HrishikeshGawasIIITH/4bit-cla-adder-180nm/post_layout_sim/full_chip/cla_final_layout.cir

.include TSMC_180nm.txt

.param LAMBDA=0.09u
.param W=20*LAMBDA
.param width_N=W
.param width_P=2*W
.global gnd vdd
.option scale=0.09u

Vdd vdd gnd 1.8

Vin_a0 a0_unsync gnd PULSE(1.8 0 0.375ns 50ps 50ps 0.8ns 1.6ns 0)
Vin_a1 a1_unsync gnd PULSE(1.8 0 0.375ns 50ps 50ps 1.6ns 3.2ns 0)
Vin_a2 a2_unsync gnd PULSE(1.8 0 0.375ns 50ps 50ps 3.2ns 6.4ns 0)
Vin_a3 a3_unsync gnd PULSE(1.8 0 0.375ns 50ps 50ps 6.4ns 12.8ns 0)

Vin_b0 b0_unsync gnd PULSE(1.8 0 0.375ns 50ps 50ps 12.8ns 25.6ns 0)
Vin_b1 b1_unsync gnd PULSE(1.8 0 0.375ns 50ps 50ps 25.6ns 51.2ns 0)
Vin_b2 b2_unsync gnd PULSE(1.8 0 0.375ns 50ps 50ps 51.2ns 102.4ns 0)
Vin_b3 b3_unsync gnd PULSE(1.8 0 0.375ns 50ps 50ps 102.4ns 204.8ns 0)
*change to 0.8ns
Vin_clk clk gnd PULSE(1.8 0 0 50ps 50ps 0.4ns 0.8ns 0)



M1000 c4 c4_0/a_72_9# vdd c4_0/inverter_0/w_0_n60# CMOSP w=40 l=2
+  ad=200 pd=90 as=21320 ps=9546
M1001 c4 c4_0/a_72_9# gnd Gnd CMOSN w=20 l=2
+  ad=100 pd=50 as=10900 ps=5410
M1002 c4_0/a_72_9# g3 c4_0/a_56_49# c4_0/w_3_39# CMOSP w=40 l=2
+  ad=200 pd=90 as=440 ps=182
M1003 c4_0/a_48_9# p2 c4_0/a_24_9# Gnd CMOSN w=20 l=2
+  ad=220 pd=102 as=220 ps=102
M1004 gnd g1 c4_0/a_24_9# Gnd CMOSN w=20 l=2
+  ad=0 pd=0 as=0 ps=0
M1005 c4_0/a_9_49# p1 vdd c4_0/w_3_39# CMOSP w=40 l=2
+  ad=440 pd=182 as=0 ps=0
M1006 gnd g2 c4_0/a_48_9# Gnd CMOSN w=20 l=2
+  ad=0 pd=0 as=0 ps=0
M1007 c4_0/a_32_49# p2 vdd c4_0/w_3_39# CMOSP w=40 l=2
+  ad=440 pd=182 as=0 ps=0
M1008 gnd g3 c4_0/a_72_9# Gnd CMOSN w=20 l=2
+  ad=0 pd=0 as=120 ps=52
M1009 c4_0/a_32_49# g1 c4_0/a_9_49# c4_0/w_3_39# CMOSP w=40 l=2
+  ad=0 pd=0 as=0 ps=0
M1010 c4_0/a_56_49# p3 vdd c4_0/w_3_39# CMOSP w=40 l=2
+  ad=0 pd=0 as=0 ps=0
M1011 c4_0/a_16_9# g0 gnd Gnd CMOSN w=20 l=2
+  ad=120 pd=52 as=0 ps=0
M1012 vdd g0 c4_0/a_9_49# c4_0/w_3_39# CMOSP w=40 l=2
+  ad=0 pd=0 as=0 ps=0
M1013 c4_0/a_56_49# g2 c4_0/a_32_49# c4_0/w_3_39# CMOSP w=40 l=2
+  ad=0 pd=0 as=0 ps=0
M1014 c4_0/a_72_9# p3 c4_0/a_48_9# Gnd CMOSN w=20 l=2
+  ad=0 pd=0 as=0 ps=0
M1015 c4_0/a_24_9# p1 c4_0/a_16_9# Gnd CMOSN w=20 l=2
+  ad=0 pd=0 as=0 ps=0
M1016 c2 c2_0/a_24_9# vdd c2_0/inverter_0/w_0_n60# CMOSP w=40 l=2
+  ad=200 pd=90 as=0 ps=0
M1017 c2 c2_0/a_24_9# gnd Gnd CMOSN w=20 l=2
+  ad=100 pd=50 as=0 ps=0
M1018 gnd g1 c2_0/a_24_9# Gnd CMOSN w=20 l=2
+  ad=0 pd=0 as=120 ps=52
M1019 c2_0/a_9_49# p1 vdd c2_0/w_3_39# CMOSP w=40 l=2
+  ad=440 pd=182 as=0 ps=0
M1020 c2_0/a_24_9# g1 c2_0/a_9_49# c2_0/w_3_39# CMOSP w=40 l=2
+  ad=200 pd=90 as=0 ps=0
M1021 c2_0/a_16_9# g0 gnd Gnd CMOSN w=20 l=2
+  ad=120 pd=52 as=0 ps=0
M1022 vdd g0 c2_0/a_9_49# c2_0/w_3_39# CMOSP w=40 l=2
+  ad=0 pd=0 as=0 ps=0
M1023 c2_0/a_24_9# p1 c2_0/a_16_9# Gnd CMOSN w=20 l=2
+  ad=0 pd=0 as=0 ps=0
M1024 a0 dff_0/a_64_49# vdd dff_0/inverter_0/w_0_n60# CMOSP w=40 l=2
+  ad=200 pd=90 as=0 ps=0
M1025 a0 dff_0/a_64_49# gnd Gnd CMOSN w=20 l=2
+  ad=100 pd=50 as=0 ps=0
M1026 gnd clk dff_0/a_40_9# Gnd CMOSN w=20 l=2
+  ad=0 pd=0 as=120 ps=52
M1027 dff_0/a_64_49# dff_0/a_33_9# vdd dff_0/w_3_39# CMOSP w=40 l=2
+  ad=200 pd=90 as=0 ps=0
M1028 dff_0/a_16_9# clk dff_0/a_16_49# dff_0/w_3_39# CMOSP w=40 l=2
+  ad=200 pd=90 as=240 ps=92
M1029 vdd clk dff_0/a_33_9# dff_0/w_3_39# CMOSP w=40 l=2
+  ad=0 pd=0 as=200 ps=90
M1030 dff_0/a_64_9# dff_0/a_33_9# gnd Gnd CMOSN w=20 l=2
+  ad=120 pd=52 as=0 ps=0
M1031 dff_0/a_16_9# a0_unsync gnd Gnd CMOSN w=20 l=2
+  ad=100 pd=50 as=0 ps=0
M1032 dff_0/a_16_49# a0_unsync vdd dff_0/w_3_39# CMOSP w=40 l=2
+  ad=0 pd=0 as=0 ps=0
M1033 dff_0/a_40_9# dff_0/a_16_9# dff_0/a_33_9# Gnd CMOSN w=20 l=2
+  ad=0 pd=0 as=100 ps=50
M1034 dff_0/a_64_49# clk dff_0/a_64_9# Gnd CMOSN w=20 l=2
+  ad=100 pd=50 as=0 ps=0
M1035 b0 dff_1/a_64_49# vdd dff_1/inverter_0/w_0_n60# CMOSP w=40 l=2
+  ad=200 pd=90 as=0 ps=0
M1036 b0 dff_1/a_64_49# gnd Gnd CMOSN w=20 l=2
+  ad=100 pd=50 as=0 ps=0
M1037 gnd clk dff_1/a_40_9# Gnd CMOSN w=20 l=2
+  ad=0 pd=0 as=120 ps=52
M1038 dff_1/a_64_49# dff_1/a_33_9# vdd dff_1/w_3_39# CMOSP w=40 l=2
+  ad=200 pd=90 as=0 ps=0
M1039 dff_1/a_16_9# clk dff_1/a_16_49# dff_1/w_3_39# CMOSP w=40 l=2
+  ad=200 pd=90 as=240 ps=92
M1040 vdd clk dff_1/a_33_9# dff_1/w_3_39# CMOSP w=40 l=2
+  ad=0 pd=0 as=200 ps=90
M1041 dff_1/a_64_9# dff_1/a_33_9# gnd Gnd CMOSN w=20 l=2
+  ad=120 pd=52 as=0 ps=0
M1042 dff_1/a_16_9# b0_unsync gnd Gnd CMOSN w=20 l=2
+  ad=100 pd=50 as=0 ps=0
M1043 dff_1/a_16_49# b0_unsync vdd dff_1/w_3_39# CMOSP w=40 l=2
+  ad=0 pd=0 as=0 ps=0
M1044 dff_1/a_40_9# dff_1/a_16_9# dff_1/a_33_9# Gnd CMOSN w=20 l=2
+  ad=0 pd=0 as=100 ps=50
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
+  ad=0 pd=0 as=200 ps=90
M1129 dff_9/a_64_9# dff_9/a_33_9# gnd Gnd CMOSN w=20 l=2
+  ad=120 pd=52 as=0 ps=0
M1130 dff_9/a_16_9# s1 gnd Gnd CMOSN w=20 l=2
+  ad=100 pd=50 as=0 ps=0
M1131 dff_9/a_16_49# s1 vdd dff_9/w_3_39# CMOSP w=40 l=2
+  ad=0 pd=0 as=0 ps=0
M1132 dff_9/a_40_9# dff_9/a_16_9# dff_9/a_33_9# Gnd CMOSN w=20 l=2
+  ad=0 pd=0 as=100 ps=50
M1133 dff_9/a_64_49# clk dff_9/a_64_9# Gnd CMOSN w=20 l=2
+  ad=100 pd=50 as=0 ps=0
M1134 xor_0/a_32_9# xor_0/a_16_9# gnd Gnd CMOSN w=20 l=2
+  ad=80 pd=48 as=0 ps=0
M1135 s0 b0 xor_0/a_54_9# Gnd CMOSN w=20 l=2
+  ad=200 pd=100 as=80 ps=48
M1136 vdd b0 xor_0/a_36_6# xor_0/w_3_39# CMOSP w=40 l=2
+  ad=0 pd=0 as=200 ps=90
M1137 xor_0/a_54_9# a0 gnd Gnd CMOSN w=20 l=2
+  ad=0 pd=0 as=0 ps=0
M1138 xor_0/a_54_49# a0 vdd xor_0/w_3_39# CMOSP w=40 l=2
+  ad=160 pd=88 as=0 ps=0
M1139 s0 xor_0/a_36_6# xor_0/a_54_49# xor_0/w_3_39# CMOSP w=40 l=2
+  ad=400 pd=180 as=0 ps=0
M1140 xor_0/a_32_49# xor_0/a_16_9# vdd xor_0/w_3_39# CMOSP w=40 l=2
+  ad=160 pd=88 as=0 ps=0
M1141 xor_0/a_16_9# a0 gnd Gnd CMOSN w=20 l=2
+  ad=100 pd=50 as=0 ps=0
M1142 gnd b0 xor_0/a_36_6# Gnd CMOSN w=20 l=2
+  ad=0 pd=0 as=100 ps=50
M1143 s0 b0 xor_0/a_32_49# xor_0/w_3_39# CMOSP w=40 l=2
+  ad=0 pd=0 as=0 ps=0
M1144 xor_0/a_16_9# a0 vdd xor_0/w_3_39# CMOSP w=40 l=2
+  ad=200 pd=90 as=0 ps=0
M1145 s0 xor_0/a_36_6# xor_0/a_32_9# Gnd CMOSN w=20 l=2
+  ad=0 pd=0 as=0 ps=0
M1146 c3 c3_0/a_48_9# vdd c3_0/inverter_0/w_0_n60# CMOSP w=40 l=2
+  ad=200 pd=90 as=0 ps=0
M1147 c3 c3_0/a_48_9# gnd Gnd CMOSN w=20 l=2
+  ad=100 pd=50 as=0 ps=0
M1148 c3_0/a_48_9# p2 c3_0/a_24_9# Gnd CMOSN w=20 l=2
+  ad=120 pd=52 as=220 ps=102
M1149 gnd g1 c3_0/a_24_9# Gnd CMOSN w=20 l=2
+  ad=0 pd=0 as=0 ps=0
M1150 c3_0/a_9_49# p1 vdd c3_0/w_3_39# CMOSP w=40 l=2
+  ad=440 pd=182 as=0 ps=0
M1151 gnd g2 c3_0/a_48_9# Gnd CMOSN w=20 l=2
+  ad=0 pd=0 as=0 ps=0
M1152 c3_0/a_32_49# p2 vdd c3_0/w_3_39# CMOSP w=40 l=2
+  ad=440 pd=182 as=0 ps=0
M1153 c3_0/a_32_49# g1 c3_0/a_9_49# c3_0/w_3_39# CMOSP w=40 l=2
+  ad=0 pd=0 as=0 ps=0
M1154 c3_0/a_16_9# g0 gnd Gnd CMOSN w=20 l=2
+  ad=120 pd=52 as=0 ps=0
M1155 vdd g0 c3_0/a_9_49# c3_0/w_3_39# CMOSP w=40 l=2
+  ad=0 pd=0 as=0 ps=0
M1156 c3_0/a_48_9# g2 c3_0/a_32_49# c3_0/w_3_39# CMOSP w=40 l=2
+  ad=200 pd=90 as=0 ps=0
M1157 c3_0/a_24_9# p1 c3_0/a_16_9# Gnd CMOSN w=20 l=2
+  ad=0 pd=0 as=0 ps=0
M1158 xor_1/a_32_9# xor_1/a_16_9# gnd Gnd CMOSN w=20 l=2
+  ad=80 pd=48 as=0 ps=0
M1159 p1 b1 xor_1/a_54_9# Gnd CMOSN w=20 l=2
+  ad=200 pd=100 as=80 ps=48
M1160 vdd b1 xor_1/a_36_6# xor_1/w_3_39# CMOSP w=40 l=2
+  ad=0 pd=0 as=200 ps=90
M1161 xor_1/a_54_9# a1 gnd Gnd CMOSN w=20 l=2
+  ad=0 pd=0 as=0 ps=0
M1162 xor_1/a_54_49# a1 vdd xor_1/w_3_39# CMOSP w=40 l=2
+  ad=160 pd=88 as=0 ps=0
M1163 p1 xor_1/a_36_6# xor_1/a_54_49# xor_1/w_3_39# CMOSP w=40 l=2
+  ad=400 pd=180 as=0 ps=0
M1164 xor_1/a_32_49# xor_1/a_16_9# vdd xor_1/w_3_39# CMOSP w=40 l=2
+  ad=160 pd=88 as=0 ps=0
M1165 xor_1/a_16_9# a1 gnd Gnd CMOSN w=20 l=2
+  ad=100 pd=50 as=0 ps=0
M1166 gnd b1 xor_1/a_36_6# Gnd CMOSN w=20 l=2
+  ad=0 pd=0 as=100 ps=50
M1167 p1 b1 xor_1/a_32_49# xor_1/w_3_39# CMOSP w=40 l=2
+  ad=0 pd=0 as=0 ps=0
M1168 xor_1/a_16_9# a1 vdd xor_1/w_3_39# CMOSP w=40 l=2
+  ad=200 pd=90 as=0 ps=0
M1169 p1 xor_1/a_36_6# xor_1/a_32_9# Gnd CMOSN w=20 l=2
+  ad=0 pd=0 as=0 ps=0
M1170 xor_2/a_32_9# xor_2/a_16_9# gnd Gnd CMOSN w=20 l=2
+  ad=80 pd=48 as=0 ps=0
M1171 p2 b2 xor_2/a_54_9# Gnd CMOSN w=20 l=2
+  ad=200 pd=100 as=80 ps=48
M1172 vdd b2 xor_2/a_36_6# xor_2/w_3_39# CMOSP w=40 l=2
+  ad=0 pd=0 as=200 ps=90
M1173 xor_2/a_54_9# a2 gnd Gnd CMOSN w=20 l=2
+  ad=0 pd=0 as=0 ps=0
M1174 xor_2/a_54_49# a2 vdd xor_2/w_3_39# CMOSP w=40 l=2
+  ad=160 pd=88 as=0 ps=0
M1175 p2 xor_2/a_36_6# xor_2/a_54_49# xor_2/w_3_39# CMOSP w=40 l=2
+  ad=400 pd=180 as=0 ps=0
M1176 xor_2/a_32_49# xor_2/a_16_9# vdd xor_2/w_3_39# CMOSP w=40 l=2
+  ad=160 pd=88 as=0 ps=0
M1177 xor_2/a_16_9# a2 gnd Gnd CMOSN w=20 l=2
+  ad=100 pd=50 as=0 ps=0
M1178 gnd b2 xor_2/a_36_6# Gnd CMOSN w=20 l=2
+  ad=0 pd=0 as=100 ps=50
M1179 p2 b2 xor_2/a_32_49# xor_2/w_3_39# CMOSP w=40 l=2
+  ad=0 pd=0 as=0 ps=0
M1180 xor_2/a_16_9# a2 vdd xor_2/w_3_39# CMOSP w=40 l=2
+  ad=200 pd=90 as=0 ps=0
M1181 p2 xor_2/a_36_6# xor_2/a_32_9# Gnd CMOSN w=20 l=2
+  ad=0 pd=0 as=0 ps=0
M1182 xor_3/a_32_9# xor_3/a_16_9# gnd Gnd CMOSN w=20 l=2
+  ad=80 pd=48 as=0 ps=0
M1183 p3 b3 xor_3/a_54_9# Gnd CMOSN w=20 l=2
+  ad=200 pd=100 as=80 ps=48
M1184 vdd b3 xor_3/a_36_6# xor_3/w_3_39# CMOSP w=40 l=2
+  ad=0 pd=0 as=200 ps=90
M1185 xor_3/a_54_9# a3 gnd Gnd CMOSN w=20 l=2
+  ad=0 pd=0 as=0 ps=0
M1186 xor_3/a_54_49# a3 vdd xor_3/w_3_39# CMOSP w=40 l=2
+  ad=160 pd=88 as=0 ps=0
M1187 p3 xor_3/a_36_6# xor_3/a_54_49# xor_3/w_3_39# CMOSP w=40 l=2
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
+  ad=100 pd=50 as=0 ps=0
M1240 s2_sync dff_10/a_64_49# vdd dff_10/inverter_0/w_0_n60# CMOSP w=40 l=2
+  ad=200 pd=90 as=0 ps=0
M1241 s2_sync dff_10/a_64_49# gnd Gnd CMOSN w=20 l=2
+  ad=100 pd=50 as=0 ps=0
M1242 gnd clk dff_10/a_40_9# Gnd CMOSN w=20 l=2
+  ad=0 pd=0 as=120 ps=52
M1243 dff_10/a_64_49# dff_10/a_33_9# vdd dff_10/w_3_39# CMOSP w=40 l=2
+  ad=200 pd=90 as=0 ps=0
M1244 dff_10/a_16_9# clk dff_10/a_16_49# dff_10/w_3_39# CMOSP w=40 l=2
+  ad=200 pd=90 as=240 ps=92
M1245 vdd clk dff_10/a_33_9# dff_10/w_3_39# CMOSP w=40 l=2
+  ad=0 pd=0 as=200 ps=90
M1246 dff_10/a_64_9# dff_10/a_33_9# gnd Gnd CMOSN w=20 l=2
+  ad=120 pd=52 as=0 ps=0
M1247 dff_10/a_16_9# s2 gnd Gnd CMOSN w=20 l=2
+  ad=100 pd=50 as=0 ps=0
M1248 dff_10/a_16_49# s2 vdd dff_10/w_3_39# CMOSP w=40 l=2
+  ad=0 pd=0 as=0 ps=0
M1249 dff_10/a_40_9# dff_10/a_16_9# dff_10/a_33_9# Gnd CMOSN w=20 l=2
+  ad=0 pd=0 as=100 ps=50
M1250 dff_10/a_64_49# clk dff_10/a_64_9# Gnd CMOSN w=20 l=2
+  ad=100 pd=50 as=0 ps=0
M1251 c4_sync dff_12/a_64_49# vdd dff_12/inverter_0/w_0_n60# CMOSP w=40 l=2
+  ad=200 pd=90 as=0 ps=0
M1252 c4_sync dff_12/a_64_49# gnd Gnd CMOSN w=20 l=2
+  ad=100 pd=50 as=0 ps=0
M1253 gnd clk dff_12/a_40_9# Gnd CMOSN w=20 l=2
+  ad=0 pd=0 as=120 ps=52
M1254 dff_12/a_64_49# dff_12/a_33_9# vdd dff_12/w_3_39# CMOSP w=40 l=2
+  ad=200 pd=90 as=0 ps=0
M1255 dff_12/a_16_9# clk dff_12/a_16_49# dff_12/w_3_39# CMOSP w=40 l=2
+  ad=200 pd=90 as=240 ps=92
M1256 vdd clk dff_12/a_33_9# dff_12/w_3_39# CMOSP w=40 l=2
+  ad=0 pd=0 as=200 ps=90
M1257 dff_12/a_64_9# dff_12/a_33_9# gnd Gnd CMOSN w=20 l=2
+  ad=120 pd=52 as=0 ps=0
M1258 dff_12/a_16_9# c4 gnd Gnd CMOSN w=20 l=2
+  ad=100 pd=50 as=0 ps=0
M1259 dff_12/a_16_49# c4 vdd dff_12/w_3_39# CMOSP w=40 l=2
+  ad=0 pd=0 as=0 ps=0
M1260 dff_12/a_40_9# dff_12/a_16_9# dff_12/a_33_9# Gnd CMOSN w=20 l=2
+  ad=0 pd=0 as=100 ps=50
M1261 dff_12/a_64_49# clk dff_12/a_64_9# Gnd CMOSN w=20 l=2
+  ad=100 pd=50 as=0 ps=0
M1262 s3_sync dff_11/a_64_49# vdd dff_11/inverter_0/w_0_n60# CMOSP w=40 l=2
+  ad=200 pd=90 as=0 ps=0
M1263 s3_sync dff_11/a_64_49# gnd Gnd CMOSN w=20 l=2
+  ad=100 pd=50 as=0 ps=0
M1264 gnd clk dff_11/a_40_9# Gnd CMOSN w=20 l=2
+  ad=0 pd=0 as=120 ps=52
M1265 dff_11/a_64_49# dff_11/a_33_9# vdd dff_11/w_3_39# CMOSP w=40 l=2
+  ad=200 pd=90 as=0 ps=0
M1266 dff_11/a_16_9# clk dff_11/a_16_49# dff_11/w_3_39# CMOSP w=40 l=2
+  ad=200 pd=90 as=240 ps=92
M1267 vdd clk dff_11/a_33_9# dff_11/w_3_39# CMOSP w=40 l=2
+  ad=0 pd=0 as=200 ps=90
M1268 dff_11/a_64_9# dff_11/a_33_9# gnd Gnd CMOSN w=20 l=2
+  ad=120 pd=52 as=0 ps=0
M1269 dff_11/a_16_9# s3 gnd Gnd CMOSN w=20 l=2
+  ad=100 pd=50 as=0 ps=0
M1270 dff_11/a_16_49# s3 vdd dff_11/w_3_39# CMOSP w=40 l=2
+  ad=0 pd=0 as=0 ps=0
M1271 dff_11/a_40_9# dff_11/a_16_9# dff_11/a_33_9# Gnd CMOSN w=20 l=2
+  ad=0 pd=0 as=100 ps=50
M1272 dff_11/a_64_49# clk dff_11/a_64_9# Gnd CMOSN w=20 l=2
+  ad=100 pd=50 as=0 ps=0
M1273 g0 and_0/a_7_63# vdd and_0/inverter_0/w_0_n60# CMOSP w=40 l=2
+  ad=200 pd=90 as=0 ps=0
M1274 g0 and_0/a_7_63# gnd Gnd CMOSN w=20 l=2
+  ad=100 pd=50 as=0 ps=0
M1275 and_0/a_7_63# b0 and_0/a_7_3# Gnd CMOSN w=40 l=2
+  ad=200 pd=90 as=240 ps=92
M1276 and_0/a_7_3# a0 gnd Gnd CMOSN w=40 l=2
+  ad=0 pd=0 as=0 ps=0
M1277 and_0/a_7_63# a0 vdd and_0/w_n6_53# CMOSP w=40 l=2
+  ad=240 pd=92 as=0 ps=0
M1278 vdd b0 and_0/a_7_63# and_0/w_n6_53# CMOSP w=40 l=2
+  ad=0 pd=0 as=0 ps=0
M1279 g1 and_1/a_7_63# vdd and_1/inverter_0/w_0_n60# CMOSP w=40 l=2
+  ad=200 pd=90 as=0 ps=0
M1280 g1 and_1/a_7_63# gnd Gnd CMOSN w=20 l=2
+  ad=100 pd=50 as=0 ps=0
M1281 and_1/a_7_63# b1 and_1/a_7_3# Gnd CMOSN w=40 l=2
+  ad=200 pd=90 as=240 ps=92
M1282 and_1/a_7_3# a1 gnd Gnd CMOSN w=40 l=2
+  ad=0 pd=0 as=0 ps=0
M1283 and_1/a_7_63# a1 vdd and_1/w_n6_53# CMOSP w=40 l=2
+  ad=240 pd=92 as=0 ps=0
M1284 vdd b1 and_1/a_7_63# and_1/w_n6_53# CMOSP w=40 l=2
+  ad=0 pd=0 as=0 ps=0
M1285 g2 and_2/a_7_63# vdd and_2/inverter_0/w_0_n60# CMOSP w=40 l=2
+  ad=200 pd=90 as=0 ps=0
M1286 g2 and_2/a_7_63# gnd Gnd CMOSN w=20 l=2
+  ad=100 pd=50 as=0 ps=0
M1287 and_2/a_7_63# b2 and_2/a_7_3# Gnd CMOSN w=40 l=2
+  ad=200 pd=90 as=240 ps=92
M1288 and_2/a_7_3# a2 gnd Gnd CMOSN w=40 l=2
+  ad=0 pd=0 as=0 ps=0
M1289 and_2/a_7_63# a2 vdd and_2/w_n6_53# CMOSP w=40 l=2
+  ad=240 pd=92 as=0 ps=0
M1290 vdd b2 and_2/a_7_63# and_2/w_n6_53# CMOSP w=40 l=2
+  ad=0 pd=0 as=0 ps=0
M1291 g3 and_3/a_7_63# vdd and_3/inverter_0/w_0_n60# CMOSP w=40 l=2
+  ad=200 pd=90 as=0 ps=0
M1292 g3 and_3/a_7_63# gnd Gnd CMOSN w=20 l=2
+  ad=100 pd=50 as=0 ps=0
M1293 and_3/a_7_63# b3 and_3/a_7_3# Gnd CMOSN w=40 l=2
+  ad=200 pd=90 as=240 ps=92
M1294 and_3/a_7_3# a3 gnd Gnd CMOSN w=40 l=2
+  ad=0 pd=0 as=0 ps=0
M1295 and_3/a_7_63# a3 vdd and_3/w_n6_53# CMOSP w=40 l=2
+  ad=240 pd=92 as=0 ps=0
M1296 vdd b3 and_3/a_7_63# and_3/w_n6_53# CMOSP w=40 l=2
+  ad=0 pd=0 as=0 ps=0
C0 p1 xor_1/a_36_6# 1.37fF
C1 s3 p3 0.42fF
C2 dff_3/a_16_9# dff_3/a_33_9# 0.17fF
C3 dff_0/a_16_9# gnd 0.24fF
C4 vdd inv_1/w_0_n60# 0.14fF
C5 xor_3/a_16_9# a3 0.07fF
C6 vdd a2 1.59fF
C7 gnd b1 0.90fF
C8 vdd dff_6/a_33_9# 0.45fF
C9 vdd dff_5/a_64_49# 0.45fF
C10 and_1/inverter_0/w_0_n60# vdd 0.14fF
C11 dff_3/a_33_9# vdd 0.45fF
C12 vdd dff_2/w_3_39# 0.39fF
C13 dff_7/w_3_39# b3_unsync 0.12fF
C14 c2_0/a_24_9# gnd 0.32fF
C15 dff_2/w_3_39# dff_2/a_16_9# 0.14fF
C16 s0 xor_0/a_16_9# 0.03fF
C17 b3 xor_3/w_3_39# 0.34fF
C18 dff_6/a_16_9# dff_6/a_33_9# 0.17fF
C19 vdd dff_4/w_3_39# 0.39fF
C20 c4_0/w_3_39# p2 0.23fF
C21 c4_0/inverter_0/w_0_n60# c4_0/a_72_9# 0.09fF
C22 xor_6/a_36_6# gnd 0.24fF
C23 vdd inv_3/w_0_n60# 0.14fF
C24 xor_1/w_3_39# b1 0.38fF
C25 gnd xor_1/a_16_9# 0.50fF
C26 c2_0/w_3_39# vdd 0.13fF
C27 vdd c4_0/a_9_49# 0.95fF
C28 s3 dff_11/w_3_39# 0.12fF
C29 and_3/w_n6_53# and_3/a_7_63# 0.04fF
C30 dff_6/inverter_0/w_0_n60# a3 0.08fF
C31 vdd and_2/a_7_63# 0.86fF
C32 dff_1/a_16_9# gnd 0.24fF
C33 and_2/a_7_3# gnd 0.47fF
C34 vdd dff_3/a_64_49# 0.45fF
C35 clk dff_8/a_16_9# 0.05fF
C36 gnd b2 0.79fF
C37 c2 xor_4/w_3_39# 0.18fF
C38 dff_7/w_3_39# vdd 0.39fF
C39 dff_11/a_16_9# gnd 0.24fF
C40 dff_9/a_64_49# dff_9/w_3_39# 0.08fF
C41 dff_9/a_33_9# dff_9/a_16_9# 0.17fF
C42 and_0/a_7_63# g0 0.05fF
C43 g0 gnd 1.93fF
C44 dff_0/inverter_0/w_0_n60# dff_0/a_64_49# 0.09fF
C45 b0_unsync dff_1/w_3_39# 0.12fF
C46 xor_1/w_3_39# xor_1/a_16_9# 0.16fF
C47 inv_2/w_0_n60# s2_sync 0.09fF
C48 s1 s0 0.11fF
C49 vdd dff_10/a_64_49# 0.45fF
C50 c3_0/a_16_9# c3_0/a_24_9# 0.21fF
C51 c4_0/a_48_9# p3 0.29fF
C52 c3_0/a_9_49# c3_0/a_32_49# 0.48fF
C53 dff_7/w_3_39# dff_7/a_16_9# 0.14fF
C54 a3 b3 0.24fF
C55 clk dff_5/a_33_9# 0.11fF
C56 c2_0/a_24_9# p2 0.22fF
C57 vdd dff_10/a_33_9# 0.45fF
C58 inv_1/a_13_n90# inv_1/w_0_n60# 0.08fF
C59 p1 gnd 0.87fF
C60 b2_unsync gnd 0.04fF
C61 dff_5/a_16_9# clk 0.66fF
C62 xor_2/a_16_9# a2 0.07fF
C63 c2 xor_4/a_16_9# 0.07fF
C64 vdd dff_7/a_33_9# 0.45fF
C65 vdd inv_4/a_13_n90# 0.50fF
C66 c4_0/w_3_39# g2 0.14fF
C67 c4 vdd 0.83fF
C68 xor_0/a_36_6# xor_0/w_3_39# 0.66fF
C69 s0 b0 0.51fF
C70 dff_1/a_33_9# gnd 0.03fF
C71 dff_12/inverter_0/w_0_n60# dff_12/a_64_49# 0.09fF
C72 vdd dff_8/inverter_0/w_0_n60# 0.14fF
C73 xor_5/a_36_6# s0 0.06fF
C74 inv_3/w_0_n60# inv_3/a_13_n90# 0.08fF
C75 p1 xor_1/w_3_39# 0.33fF
C76 dff_7/a_16_9# dff_7/a_33_9# 0.17fF
C77 clk dff_12/a_33_9# 0.11fF
C78 a1 b1 0.34fF
C79 s0 clk 0.12fF
C80 vdd s0_sync 0.45fF
C81 c3_0/a_9_49# vdd 0.95fF
C82 p2 b2 0.44fF
C83 dff_5/w_3_39# dff_5/a_33_9# 0.21fF
C84 c4 dff_12/w_3_39# 0.12fF
C85 dff_5/a_16_9# dff_5/w_3_39# 0.14fF
C86 b0 and_1/a_7_63# 0.08fF
C87 g0 p2 0.07fF
C88 dff_9/a_33_9# gnd 0.03fF
C89 xor_1/a_36_6# gnd 0.24fF
C90 dff_4/a_64_49# a2 0.05fF
C91 a1_unsync gnd 0.04fF
C92 a1 and_1/w_n6_53# 0.64fF
C93 clk s3 0.12fF
C94 a3 and_3/w_n6_53# 0.32fF
C95 c3 xor_6/a_16_9# 0.07fF
C96 inv_2/w_0_n60# inv_2/a_13_n90# 0.08fF
C97 p1 c4_0/a_24_9# 0.18fF
C98 c3_0/a_32_49# g1 0.07fF
C99 vdd and_2/inverter_0/w_0_n60# 0.14fF
C100 and_0/a_7_63# a0 0.09fF
C101 a1 xor_1/a_16_9# 0.07fF
C102 gnd dff_4/a_16_9# 0.24fF
C103 gnd a0 1.24fF
C104 p1 p2 0.09fF
C105 vdd xor_6/a_16_9# 0.86fF
C106 clk dff_4/a_33_9# 0.11fF
C107 c4_0/w_3_39# g3 0.12fF
C108 vdd and_0/inverter_0/w_0_n60# 0.14fF
C109 dff_9/a_16_9# gnd 0.24fF
C110 vdd dff_6/w_3_39# 0.39fF
C111 c3_0/a_9_49# c3_0/w_3_39# 0.12fF
C112 dff_4/a_64_49# dff_4/w_3_39# 0.08fF
C113 dff_0/a_33_9# gnd 0.03fF
C114 xor_1/w_3_39# xor_1/a_36_6# 0.66fF
C115 xor_6/w_3_39# xor_6/a_36_6# 0.66fF
C116 p3 xor_6/a_16_9# 0.42fF
C117 vdd xor_2/w_3_39# 0.47fF
C118 dff_3/w_3_39# b1_unsync 0.12fF
C119 clk dff_6/a_33_9# 0.11fF
C120 dff_3/a_33_9# clk 0.11fF
C121 clk dff_2/w_3_39# 0.60fF
C122 and_0/w_n6_53# vdd 0.20fF
C123 dff_6/w_3_39# dff_6/a_16_9# 0.14fF
C124 c4_0/w_3_39# c4_0/a_72_9# 0.08fF
C125 g2 b2 0.08fF
C126 g2 xor_2/a_54_49# 0.00fF
C127 xor_5/a_16_9# s0 0.06fF
C128 vdd xor_0/w_3_39# 0.47fF
C129 p1 a1 0.08fF
C130 vdd g1 1.28fF
C131 and_0/a_7_3# gnd 0.47fF
C132 and_0/a_7_63# and_0/a_7_3# 0.47fF
C133 clk dff_4/w_3_39# 0.60fF
C134 dff_10/a_33_9# dff_10/a_16_9# 0.17fF
C135 dff_6/a_64_49# gnd 0.09fF
C136 vdd c4_0/a_56_49# 0.95fF
C137 xor_0/a_36_6# vdd 0.64fF
C138 dff_8/a_64_49# dff_8/inverter_0/w_0_n60# 0.09fF
C139 vdd and_3/inverter_0/w_0_n60# 0.14fF
C140 c2_0/a_24_9# c2_0/inverter_0/w_0_n60# 0.09fF
C141 and_3/a_7_63# b2 0.24fF
C142 c4_sync gnd 0.29fF
C143 p1 g2 0.01fF
C144 xor_2/a_36_6# b2 0.32fF
C145 dff_5/a_64_49# dff_5/w_3_39# 0.08fF
C146 dff_7/w_3_39# clk 0.60fF
C147 dff_8/a_64_49# s0_sync 0.05fF
C148 p3 c4_0/a_56_49# 0.18fF
C149 gnd inv_0/a_13_n90# 0.24fF
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
