HrishikeshGawasIIITH/4bit-cla-adder-180nm/post_layout_sim/full_chip/delay/cla_delay_c4.cir

.include TSMC_180nm.txt

.param LAMBDA=0.09u
.param W=20*LAMBDA
.param width_N=W
.param width_P=2*W
.global gnd vdd
.option scale=0.09u

Vdd vdd gnd 1.8

Vin_a0 a0 gnd PULSE(0 1.8 0.5ns 50ps 50ps 3ns 4ns 0)
Vin_a1 a1 gnd PULSE(0 1.8 0.5ns 50ps 50ps 3ns 4ns 0)
Vin_a2 a2 gnd PULSE(0 1.8 0.5ns 50ps 50ps 3ns 4ns 0)
Vin_a3 a3 gnd PULSE(0 1.8 0.5ns 50ps 50ps 3ns 4ns 0)

Vin_b0 b0 gnd PULSE(0 1.8 1.25ns 50ps 50ps 1ns 2ns 0)
Vin_b1 b1 gnd 0V
Vin_b2 b2 gnd 0V
Vin_b3 b3 gnd 0V



M1000 c4 c4_0/a_72_9# vdd c4_0/inverter_0/w_0_n60# CMOSP w=40 l=2
+  ad=200 pd=90 as=21320 ps=9546
M1001 c4 c4_0/a_72_9# gnd Gnd CMOSN w=20 l=2
+  ad=100 pd=50 as=10900 ps=5410
M1002 c4_0/a_72_9# g3 c4_0/a_56_49# c4_0/w_3_39# CMOSP w=40 l=2
+  ad=200 pd=90 as=440 ps=182
M1003 c4_0/a_48_9# p2 c4_0/a_24_9# Gnd CMOSN w=20 l=2
+  ad=220 pd=102 as=220 ps=102
M1004 gnd g1 c4_0/a_24_9# Gnd CMOSN w=20 l=2
+  ad=0 pd=0 as=0 ps=0
M1005 c4_0/a_9_49# p1 vdd c4_0/w_3_39# CMOSP w=40 l=2
+  ad=440 pd=182 as=0 ps=0
M1006 gnd g2 c4_0/a_48_9# Gnd CMOSN w=20 l=2
+  ad=0 pd=0 as=0 ps=0
M1007 c4_0/a_32_49# p2 vdd c4_0/w_3_39# CMOSP w=40 l=2
+  ad=440 pd=182 as=0 ps=0
M1008 gnd g3 c4_0/a_72_9# Gnd CMOSN w=20 l=2
+  ad=0 pd=0 as=120 ps=52
M1009 c4_0/a_32_49# g1 c4_0/a_9_49# c4_0/w_3_39# CMOSP w=40 l=2
+  ad=0 pd=0 as=0 ps=0
M1010 c4_0/a_56_49# p3 vdd c4_0/w_3_39# CMOSP w=40 l=2
+  ad=0 pd=0 as=0 ps=0
M1011 c4_0/a_16_9# g0 gnd Gnd CMOSN w=20 l=2
+  ad=120 pd=52 as=0 ps=0
M1012 vdd g0 c4_0/a_9_49# c4_0/w_3_39# CMOSP w=40 l=2
+  ad=0 pd=0 as=0 ps=0
M1013 c4_0/a_56_49# g2 c4_0/a_32_49# c4_0/w_3_39# CMOSP w=40 l=2
+  ad=0 pd=0 as=0 ps=0
M1014 c4_0/a_72_9# p3 c4_0/a_48_9# Gnd CMOSN w=20 l=2
+  ad=0 pd=0 as=0 ps=0
M1015 c4_0/a_24_9# p1 c4_0/a_16_9# Gnd CMOSN w=20 l=2
+  ad=0 pd=0 as=0 ps=0
M1016 c2 c2_0/a_24_9# vdd c2_0/inverter_0/w_0_n60# CMOSP w=40 l=2
+  ad=200 pd=90 as=0 ps=0
M1017 c2 c2_0/a_24_9# gnd Gnd CMOSN w=20 l=2
+  ad=100 pd=50 as=0 ps=0
M1018 gnd g1 c2_0/a_24_9# Gnd CMOSN w=20 l=2
+  ad=0 pd=0 as=120 ps=52
M1019 c2_0/a_9_49# p1 vdd c2_0/w_3_39# CMOSP w=40 l=2
+  ad=440 pd=182 as=0 ps=0
M1020 c2_0/a_24_9# g1 c2_0/a_9_49# c2_0/w_3_39# CMOSP w=40 l=2
+  ad=200 pd=90 as=0 ps=0
M1021 c2_0/a_16_9# g0 gnd Gnd CMOSN w=20 l=2
+  ad=120 pd=52 as=0 ps=0
M1022 vdd g0 c2_0/a_9_49# c2_0/w_3_39# CMOSP w=40 l=2
+  ad=0 pd=0 as=0 ps=0
M1023 c2_0/a_24_9# p1 c2_0/a_16_9# Gnd CMOSN w=20 l=2
+  ad=0 pd=0 as=0 ps=0
M1024 a0 dff_0/a_64_49# vdd dff_0/inverter_0/w_0_n60# CMOSP w=40 l=2
+  ad=200 pd=90 as=0 ps=0
M1025 a0 dff_0/a_64_49# gnd Gnd CMOSN w=20 l=2
+  ad=100 pd=50 as=0 ps=0
M1026 gnd clk dff_0/a_40_9# Gnd CMOSN w=20 l=2
+  ad=0 pd=0 as=120 ps=52
M1027 dff_0/a_64_49# dff_0/a_33_9# vdd dff_0/w_3_39# CMOSP w=40 l=2
+  ad=200 pd=90 as=0 ps=0
M1028 dff_0/a_16_9# clk dff_0/a_16_49# dff_0/w_3_39# CMOSP w=40 l=2
+  ad=200 pd=90 as=240 ps=92
M1029 vdd clk dff_0/a_33_9# dff_0/w_3_39# CMOSP w=40 l=2
+  ad=0 pd=0 as=200 ps=90
M1030 dff_0/a_64_9# dff_0/a_33_9# gnd Gnd CMOSN w=20 l=2
+  ad=120 pd=52 as=0 ps=0
M1031 dff_0/a_16_9# a0_unsync gnd Gnd CMOSN w=20 l=2
+  ad=100 pd=50 as=0 ps=0
M1032 dff_0/a_16_49# a0_unsync vdd dff_0/w_3_39# CMOSP w=40 l=2
+  ad=0 pd=0 as=0 ps=0
M1033 dff_0/a_40_9# dff_0/a_16_9# dff_0/a_33_9# Gnd CMOSN w=20 l=2
+  ad=0 pd=0 as=100 ps=50
M1034 dff_0/a_64_49# clk dff_0/a_64_9# Gnd CMOSN w=20 l=2
+  ad=100 pd=50 as=0 ps=0
M1035 b0 dff_1/a_64_49# vdd dff_1/inverter_0/w_0_n60# CMOSP w=40 l=2
+  ad=200 pd=90 as=0 ps=0
M1036 b0 dff_1/a_64_49# gnd Gnd CMOSN w=20 l=2
+  ad=100 pd=50 as=0 ps=0
M1037 gnd clk dff_1/a_40_9# Gnd CMOSN w=20 l=2
+  ad=0 pd=0 as=120 ps=52
M1038 dff_1/a_64_49# dff_1/a_33_9# vdd dff_1/w_3_39# CMOSP w=40 l=2
+  ad=200 pd=90 as=0 ps=0
M1039 dff_1/a_16_9# clk dff_1/a_16_49# dff_1/w_3_39# CMOSP w=40 l=2
+  ad=200 pd=90 as=240 ps=92
M1040 vdd clk dff_1/a_33_9# dff_1/w_3_39# CMOSP w=40 l=2
+  ad=0 pd=0 as=200 ps=90
M1041 dff_1/a_64_9# dff_1/a_33_9# gnd Gnd CMOSN w=20 l=2
+  ad=120 pd=52 as=0 ps=0
M1042 dff_1/a_16_9# b0_unsync gnd Gnd CMOSN w=20 l=2
+  ad=100 pd=50 as=0 ps=0
M1043 dff_1/a_16_49# b0_unsync vdd dff_1/w_3_39# CMOSP w=40 l=2
+  ad=0 pd=0 as=0 ps=0
M1044 dff_1/a_40_9# dff_1/a_16_9# dff_1/a_33_9# Gnd CMOSN w=20 l=2
+  ad=0 pd=0 as=100 ps=50
M1045 dff_1/a_64_49# clk dff_1/a_64_9# Gnd CMOSN w=20 l=2
+  ad=100 pd=50 as=0 ps=0
M1046 a1 dff_2/a_64_49# vdd dff_2/inverter_0/w_0_n60# CMOSP w=40 l=2
+  ad=200 pd=90 as=0 ps=0
M1047 a1 dff_2/a_64_49# gnd Gnd CMOSN w=20 l=2
+  ad=100 pd=50 as=0 ps=0
M1048 gnd clk dff_2/a_40_9# Gnd CMOSN w=20 l=2
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
+  ad=0 pd=0 as=100 ps=50
M1207 s2 p2 xor_4/a_32_49# xor_4/w_3_39# CMOSP w=40 l=2
+  ad=0 pd=0 as=0 ps=0
M1208 xor_4/a_16_9# c2 vdd xor_4/w_3_39# CMOSP w=40 l=2
+  ad=200 pd=90 as=0 ps=0
M1209 s2 xor_4/a_36_6# xor_4/a_32_9# Gnd CMOSN w=20 l=2
+  ad=0 pd=0 as=0 ps=0
M1210 inv_2/a_13_n90# s2_sync vdd inv_2/w_0_n60# CMOSP w=40 l=2
+  ad=200 pd=90 as=0 ps=0
M1211 inv_2/a_13_n90# s2_sync gnd Gnd CMOSN w=20 l=2
+  ad=100 pd=50 as=0 ps=0
M1212 xor_5/a_32_9# xor_5/a_16_9# gnd Gnd CMOSN w=20 l=2
+  ad=80 pd=48 as=0 ps=0
M1213 s1 p1 xor_5/a_54_9# Gnd CMOSN w=20 l=2
+  ad=200 pd=100 as=80 ps=48
M1214 vdd p1 xor_5/a_36_6# xor_5/w_3_39# CMOSP w=40 l=2
+  ad=0 pd=0 as=200 ps=90
M1215 xor_5/a_54_9# g0 gnd Gnd CMOSN w=20 l=2
+  ad=0 pd=0 as=0 ps=0
M1216 xor_5/a_54_49# g0 vdd xor_5/w_3_39# CMOSP w=40 l=2
+  ad=160 pd=88 as=0 ps=0
M1217 s1 xor_5/a_36_6# xor_5/a_54_49# xor_5/w_3_39# CMOSP w=40 l=2
+  ad=400 pd=180 as=0 ps=0
M1218 xor_5/a_32_49# xor_5/a_16_9# vdd xor_5/w_3_39# CMOSP w=40 l=2
+  ad=160 pd=88 as=0 ps=0
M1219 xor_5/a_16_9# g0 gnd Gnd CMOSN w=20 l=2
+  ad=100 pd=50 as=0 ps=0
M1220 gnd p1 xor_5/a_36_6# Gnd CMOSN w=20 l=2
+  ad=0 pd=0 as=100 ps=50
M1221 s1 p1 xor_5/a_32_49# xor_5/w_3_39# CMOSP w=40 l=2
+  ad=0 pd=0 as=0 ps=0
M1222 xor_5/a_16_9# g0 vdd xor_5/w_3_39# CMOSP w=40 l=2
+  ad=200 pd=90 as=0 ps=0
M1223 s1 xor_5/a_36_6# xor_5/a_32_9# Gnd CMOSN w=20 l=2
+  ad=0 pd=0 as=0 ps=0
M1224 inv_3/a_13_n90# s3_sync vdd inv_3/w_0_n60# CMOSP w=40 l=2
+  ad=200 pd=90 as=0 ps=0
M1225 inv_3/a_13_n90# s3_sync gnd Gnd CMOSN w=20 l=2
+  ad=100 pd=50 as=0 ps=0
M1226 xor_6/a_32_9# xor_6/a_16_9# gnd Gnd CMOSN w=20 l=2
+  ad=80 pd=48 as=0 ps=0
M1227 s3 p3 xor_6/a_54_9# Gnd CMOSN w=20 l=2
+  ad=200 pd=100 as=80 ps=48
M1228 vdd p3 xor_6/a_36_6# xor_6/w_3_39# CMOSP w=40 l=2
+  ad=0 pd=0 as=200 ps=90
M1229 xor_6/a_54_9# c3 gnd Gnd CMOSN w=20 l=2
+  ad=0 pd=0 as=0 ps=0
M1230 xor_6/a_54_49# c3 vdd xor_6/w_3_39# CMOSP w=40 l=2
+  ad=160 pd=88 as=0 ps=0
M1231 s3 xor_6/a_36_6# xor_6/a_54_49# xor_6/w_3_39# CMOSP w=40 l=2
+  ad=400 pd=180 as=0 ps=0
M1232 xor_6/a_32_49# xor_6/a_16_9# vdd xor_6/w_3_39# CMOSP w=40 l=2
+  ad=160 pd=88 as=0 ps=0
M1233 xor_6/a_16_9# c3 gnd Gnd CMOSN w=20 l=2
+  ad=100 pd=50 as=0 ps=0
M1234 gnd p3 xor_6/a_36_6# Gnd CMOSN w=20 l=2
+  ad=0 pd=0 as=100 ps=50
M1235 s3 p3 xor_6/a_32_49# xor_6/w_3_39# CMOSP w=40 l=2
+  ad=0 pd=0 as=0 ps=0
M1236 xor_6/a_16_9# c3 vdd xor_6/w_3_39# CMOSP w=40 l=2
+  ad=200 pd=90 as=0 ps=0
M1237 s3 xor_6/a_36_6# xor_6/a_32_9# Gnd CMOSN w=20 l=2
+  ad=0 pd=0 as=0 ps=0
M1238 inv_4/a_13_n90# c4_sync vdd inv_4/w_0_n60# CMOSP w=40 l=2
+  ad=200 pd=90 as=0 ps=0
M1239 inv_4/a_13_n90# c4_sync gnd Gnd CMOSN w=20 l=2
+  ad=100 pd=50 as=0 ps=0
M1240 s2_sync dff_10/a_64_49# vdd dff_10/inverter_0/w_0_n60# CMOSP w=40 l=2
+  ad=200 pd=90 as=0 ps=0
M1241 s2_sync dff_10/a_64_49# gnd Gnd CMOSN w=20 l=2
+  ad=100 pd=50 as=0 ps=0
M1242 gnd clk dff_10/a_40_9# Gnd CMOSN w=20 l=2
+  ad=0 pd=0 as=120 ps=52
M1243 dff_10/a_64_49# dff_10/a_33_9# vdd dff_10/w_3_39# CMOSP w=40 l=2
+  ad=200 pd=90 as=0 ps=0
M1244 dff_10/a_16_9# clk dff_10/a_16_49# dff_10/w_3_39# CMOSP w=40 l=2
+  ad=200 pd=90 as=240 ps=92
M1245 vdd clk dff_10/a_33_9# dff_10/w_3_39# CMOSP w=40 l=2
+  ad=0 pd=0 as=200 ps=90
M1246 dff_10/a_64_9# dff_10/a_33_9# gnd Gnd CMOSN w=20 l=2
+  ad=120 pd=52 as=0 ps=0
M1247 dff_10/a_16_9# s2 gnd Gnd CMOSN w=20 l=2
+  ad=100 pd=50 as=0 ps=0
M1248 dff_10/a_16_49# s2 vdd dff_10/w_3_39# CMOSP w=40 l=2
+  ad=0 pd=0 as=0 ps=0
M1249 dff_10/a_40_9# dff_10/a_16_9# dff_10/a_33_9# Gnd CMOSN w=20 l=2
+  ad=0 pd=0 as=100 ps=50
M1250 dff_10/a_64_49# clk dff_10/a_64_9# Gnd CMOSN w=20 l=2
+  ad=100 pd=50 as=0 ps=0
M1251 c4_sync dff_12/a_64_49# vdd dff_12/inverter_0/w_0_n60# CMOSP w=40 l=2
+  ad=200 pd=90 as=0 ps=0
M1252 c4_sync dff_12/a_64_49# gnd Gnd CMOSN w=20 l=2
+  ad=100 pd=50 as=0 ps=0
M1253 gnd clk dff_12/a_40_9# Gnd CMOSN w=20 l=2
+  ad=0 pd=0 as=120 ps=52
M1254 dff_12/a_64_49# dff_12/a_33_9# vdd dff_12/w_3_39# CMOSP w=40 l=2
+  ad=200 pd=90 as=0 ps=0
M1255 dff_12/a_16_9# clk dff_12/a_16_49# dff_12/w_3_39# CMOSP w=40 l=2
+  ad=200 pd=90 as=240 ps=92
M1256 vdd clk dff_12/a_33_9# dff_12/w_3_39# CMOSP w=40 l=2
+  ad=0 pd=0 as=200 ps=90
M1257 dff_12/a_64_9# dff_12/a_33_9# gnd Gnd CMOSN w=20 l=2
+  ad=120 pd=52 as=0 ps=0
M1258 dff_12/a_16_9# c4 gnd Gnd CMOSN w=20 l=2
+  ad=100 pd=50 as=0 ps=0
M1259 dff_12/a_16_49# c4 vdd dff_12/w_3_39# CMOSP w=40 l=2
+  ad=0 pd=0 as=0 ps=0
M1260 dff_12/a_40_9# dff_12/a_16_9# dff_12/a_33_9# Gnd CMOSN w=20 l=2
+  ad=0 pd=0 as=100 ps=50
M1261 dff_12/a_64_49# clk dff_12/a_64_9# Gnd CMOSN w=20 l=2
+  ad=100 pd=50 as=0 ps=0
M1262 s3_sync dff_11/a_64_49# vdd dff_11/inverter_0/w_0_n60# CMOSP w=40 l=2
+  ad=200 pd=90 as=0 ps=0
M1263 s3_sync dff_11/a_64_49# gnd Gnd CMOSN w=20 l=2
+  ad=100 pd=50 as=0 ps=0
M1264 gnd clk dff_11/a_40_9# Gnd CMOSN w=20 l=2
+  ad=0 pd=0 as=120 ps=52
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
