HrishikeshGawasIIITH/4bit-cla-adder-180nm/verilog/rtl/tff.v

`timescale 1ns / 1ps

module tff (
    input clk,   
    input reset, 
    input t,         
    output reg q      
);

    always @(posedge clk or posedge reset) begin
        if (reset)
            q <= 1'b0; 
        else if (t)
            q <= ~q;  
    end
endmodule
